DrJeffCooke/TesLorean-Thermal-Controller/TESL Coolant Layout.png

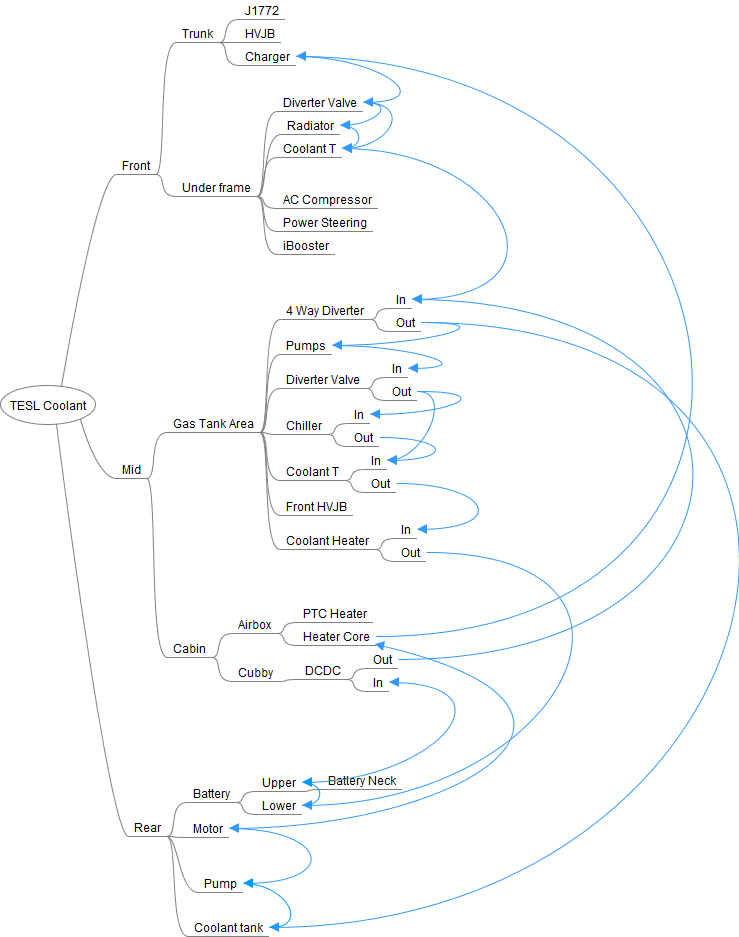
TESL Coolant Layout.png
