DrJeffCooke/TesLorean-Thermal-Controller/Thermal Routing.pdf

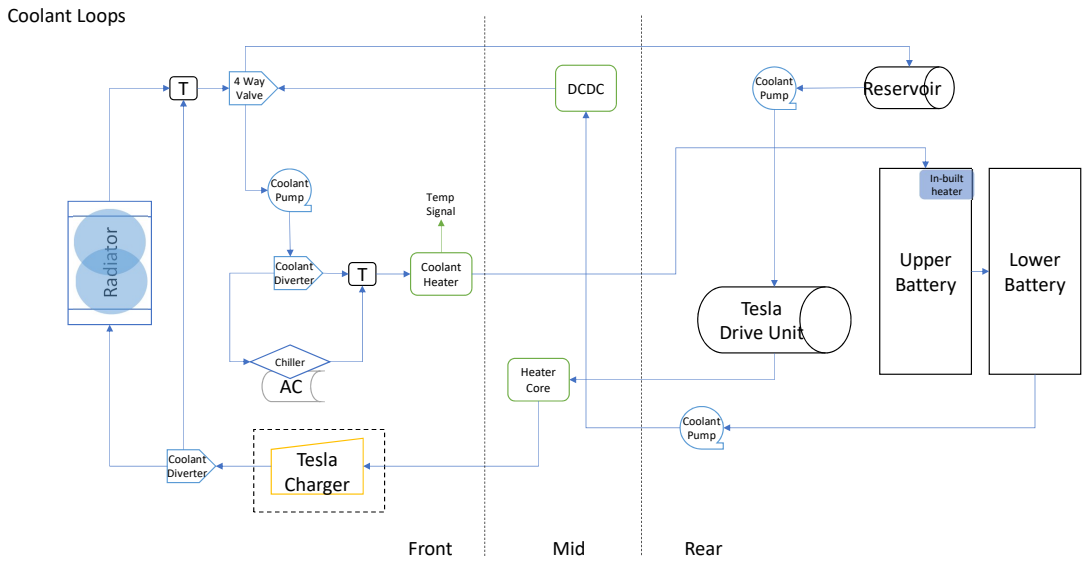
[picture p3: page 1]
Coolant Loops; Lower Battery; Upper Battery; Coolant Heater; Tesla Drive Unit; Tesla Charger; Coolant Pump; Coolant Diverter; Reservoir Radiator; Chiller; T 4 Way Valve; Coolant; Diverter; DCDC; Heater Core; Temp Signal; In-built heater; Front; Mid; Rear
