DrJeffCooke/TesLorean-Thermal-Controller/ThermalControlModule/Thermal Wiring.pptx

AC
Compressor

5v? PWM

Chiller
Solenoid

GND

12v

MOSFET

Fan

GND

12v

MOSFET

5v Control

Fan

GND

12v

MOSFET

5v Control

Coolant
Heater

5v? PWM

GND

12v

12v
GND

H Bridge

Radiator
Bypass
Valve

12v
GND

5v Digital
Control Line

PWM

5v Digital
Control
Lines (x2)
(& PWM)

PWM

12v & GND

Arduino

5v PWM 2Hz and
Analog Feedback Lines

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
H Bridge

Chiller
Bypass
Valve

10
25
26

12v & GND

L

H

CAN
Interface

SCK
MISO
MOSI
INT

11
27
28

Pump

A0 6

A1 7

A2 8

H Bridge

Regulated
5v Output

12v & GND

Loop
Connector
Valve

GND

Pump

Pump

12v

## Slide 2

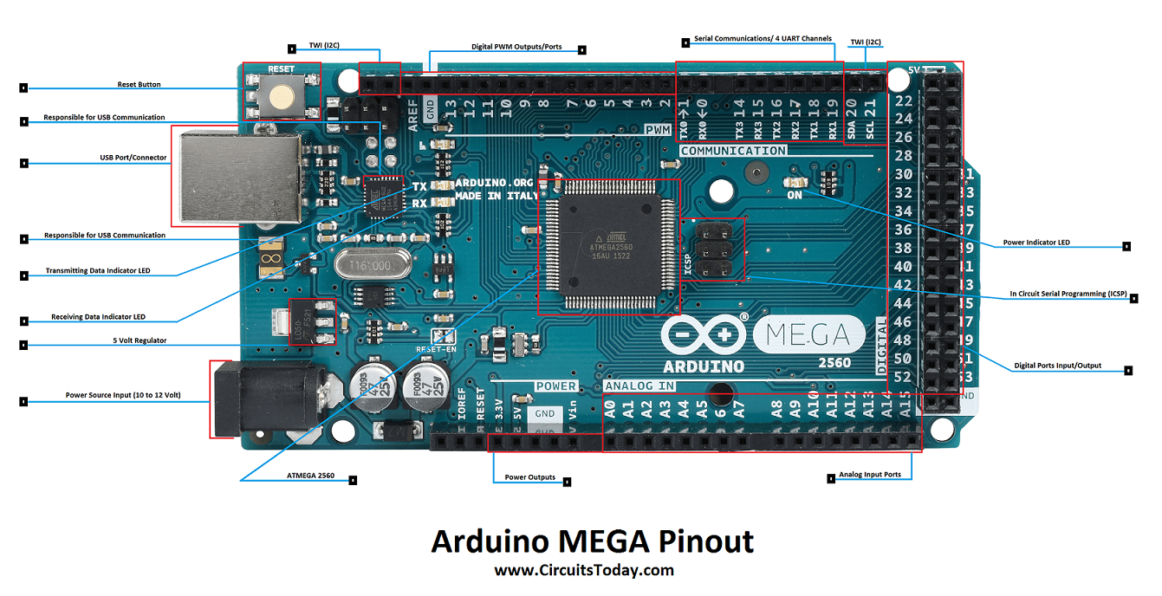
[picture p4: figure]
