DrJeffCooke/TesLorean-Thermal-Controller/(commit log)

2019-01-07 Updated design information
    PPT contains information on the planned wiring of the Arduino and modules to interface with the Pumps, Valves, Tesla parts (AC Compressor, Coolant Heater), Coolant chiller solenoid.
2019-01-07 Major code updates to Thermal Controller
    Still incomplete (probably 80% done) for Thermal Controller Code. First attempt at coding the temperature monitoring and control scheme.
